Dozgulbas/aps_robot_programs/Data_Analysis/figures/Last10_glass_avg.png

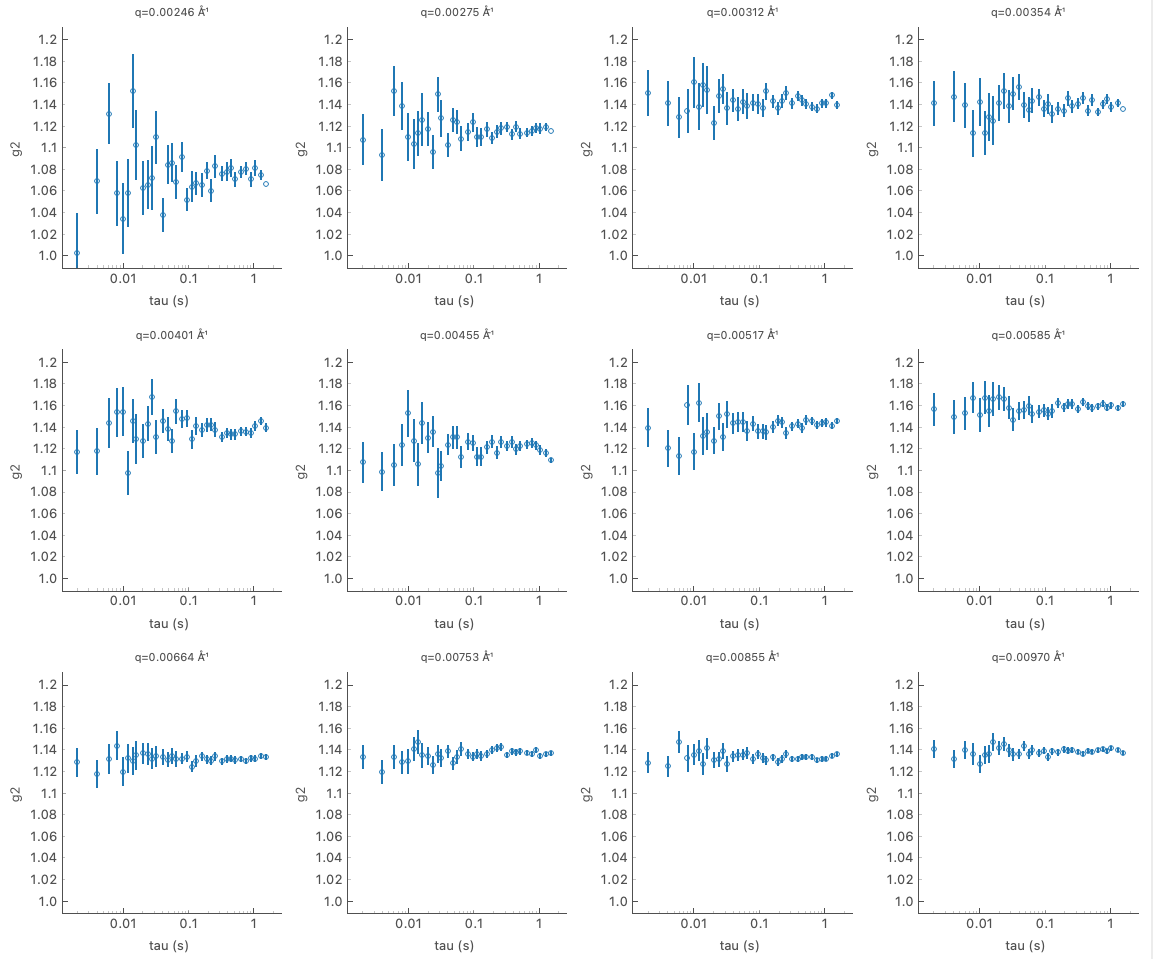
Data_Analysis/figures/Last10_glass_avg.png
