Dozgulbas/aps_robot_programs/droplet_description/meshes/pipette_assembly.stl

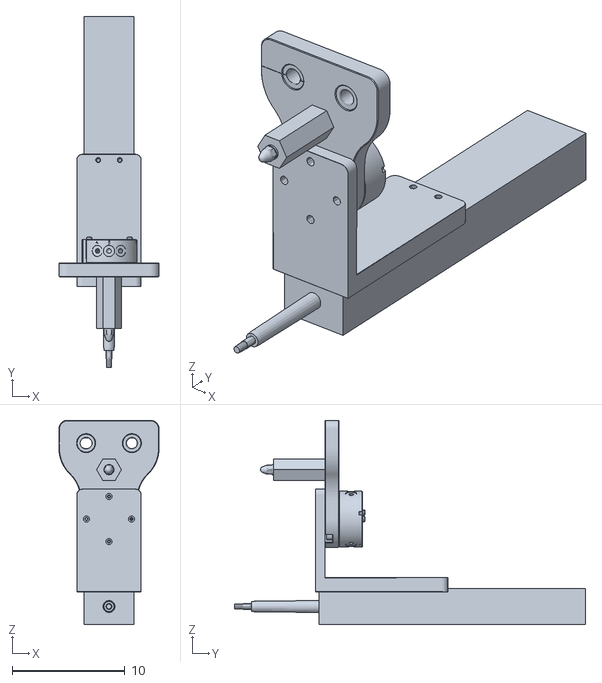
[picture p2: CAD file, 2023-04-10]
droplet_description/meshes/pipette_assembly.stl
8.89 x 31.2 x 18.1
