Dozgulbas/aps_robot_programs/droplet_description/meshes/tool_changer_tool_side.stl

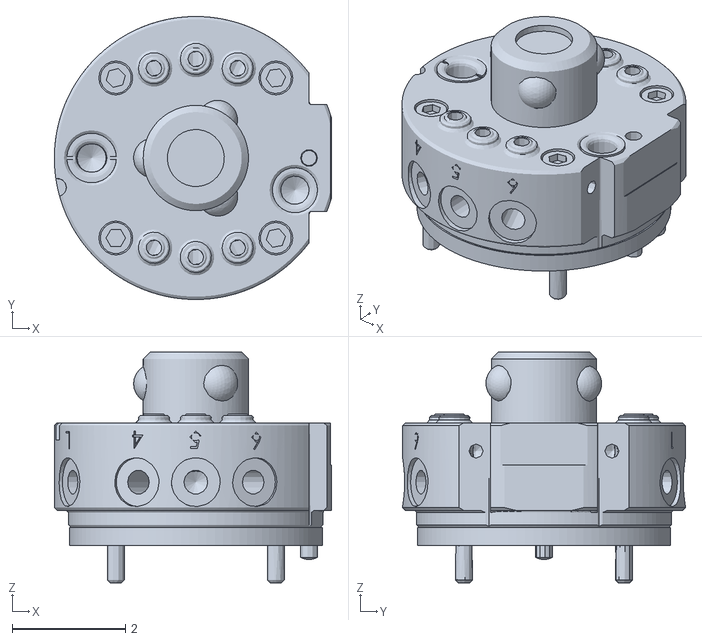
[picture p4: CAD file, 2023-04-10]
droplet_description/meshes/tool_changer_tool_side.stl
4.90 x 5.00 x 4.08
