Dozgulbas/aps_robot_programs/RoboDK_Programs/CAD_drawings/ATI-9120-011M-000-000.STEP

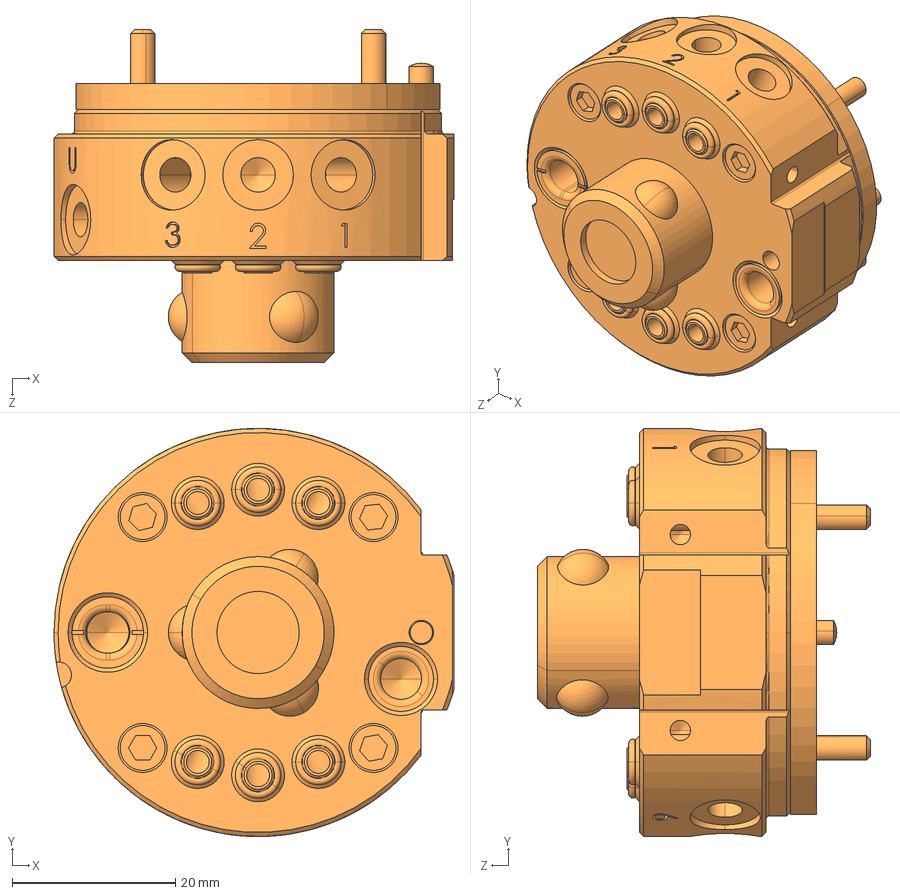
[picture p5: CAD file, 2022-11-21]
RoboDK_Programs/CAD_drawings/ATI-9120-011M-000-000.STEP
49.0 x 50.0 x 40.8 mm
