Dozgulbas/aps_robot_programs/droplet_description/meshes/300ul_tip_1.stl

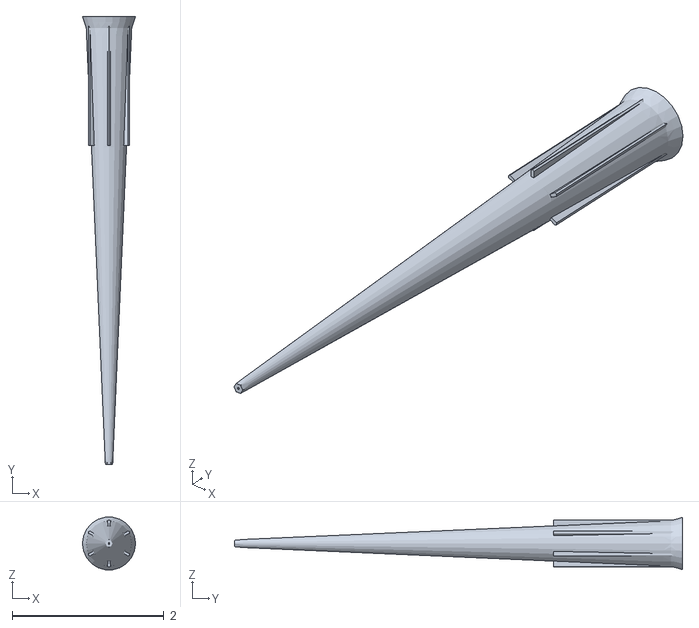
[picture p6: CAD file, 2023-04-10]
droplet_description/meshes/300ul_tip_1.stl
0.7 x 5.90 x 0.693
