Dozgulbas/aps_robot_programs/RoboDK_Programs/CAD_drawings/ATI-9120-TSS-MMB-7124.STEP

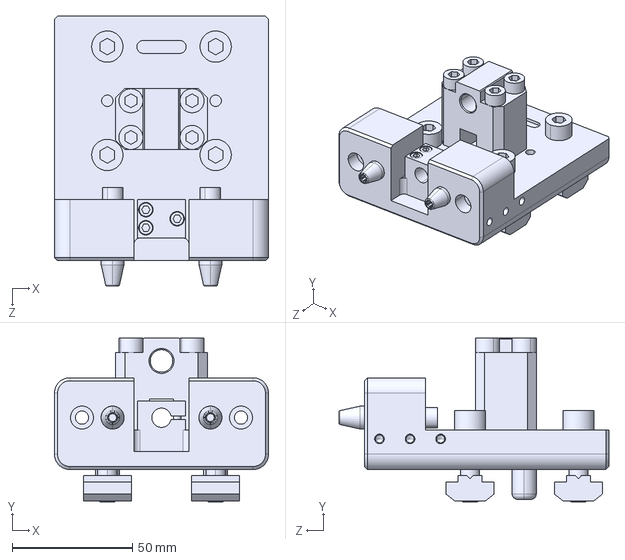
[picture p7: CAD file, 2022-11-21]
RoboDK_Programs/CAD_drawings/ATI-9120-TSS-MMB-7124.STEP
88.9 x 68.1 x 112.1 mm
