Dozgulbas/aps_robot_programs/RoboDK_Programs/CAD_drawings/ATI-9120-TSS-HBQ-7123.STEP

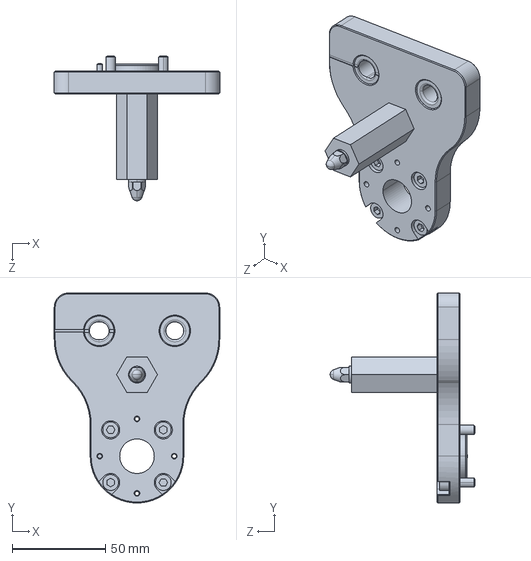
[picture p8: CAD file, 2022-11-21]
RoboDK_Programs/CAD_drawings/ATI-9120-TSS-HBQ-7123.STEP
88.9 x 112.8 x 77.8 mm
