Dozgulbas/aps_robot_programs/RoboDK_Programs/CAD_drawings/5103_a20-40--42707_68308.stp

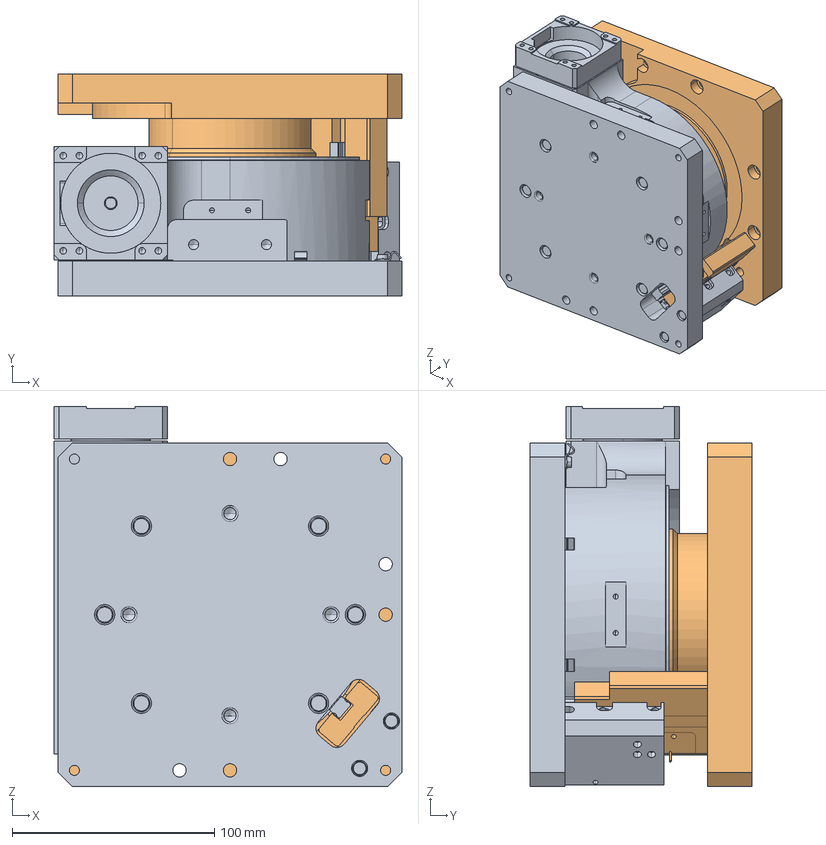
[picture p9: CAD file, 2022-11-21]
RoboDK_Programs/CAD_drawings/5103_a20-40--42707_68308.stp
172.0 x 110.0 x 188.0 mm
5103_A20_BASIS
5103_A20-SUPPORT
