Dozgulbas/aps_robot_programs/RoboDK_Programs/CAD_drawings/L-Bracket.STEP

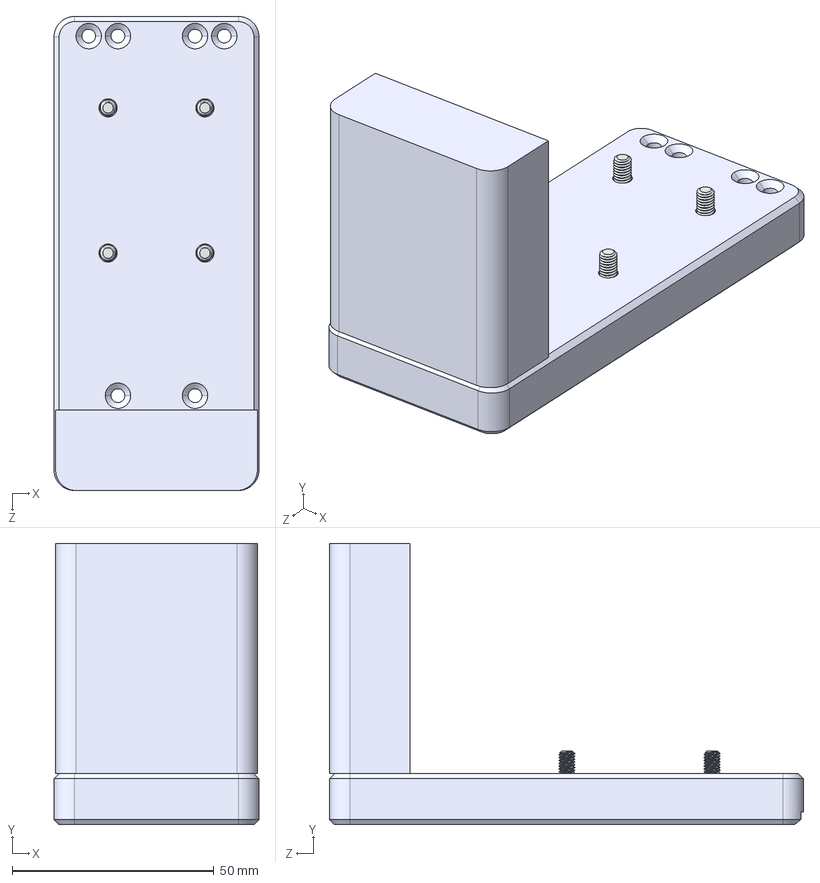
[picture p10: CAD file, 2022-11-21]
RoboDK_Programs/CAD_drawings/L-Bracket.STEP
50.8 x 69.8 x 117.5 mm
P1000 GEN2 Adapter Plate
SHC-M4X10-91292A116_91292A116 x 4
Tool Plate Adapter
