Dozgulbas/aps_robot_programs/RoboDK_Programs/CAD_drawings/5102_20-30--39103.stp

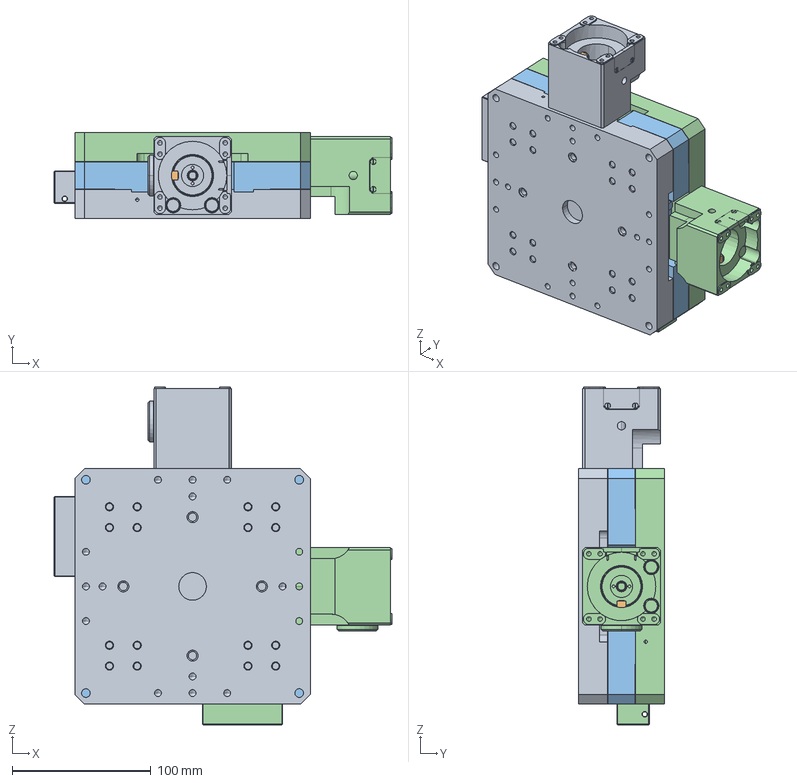
[picture p11: CAD file, 2022-11-21]
RoboDK_Programs/CAD_drawings/5102_20-30--39103.stp
244.1 x 62.0 x 244.1 mm
5102_20-30--39103_BASE
5102_20-30--39103_CROSS_SLIDE
5102_20-30--39103_TOP_SLIDE
