Dozgulbas/aps_robot_programs/RoboDK_Programs/CAD_drawings/ATI-9120-011T-000-000.STEP

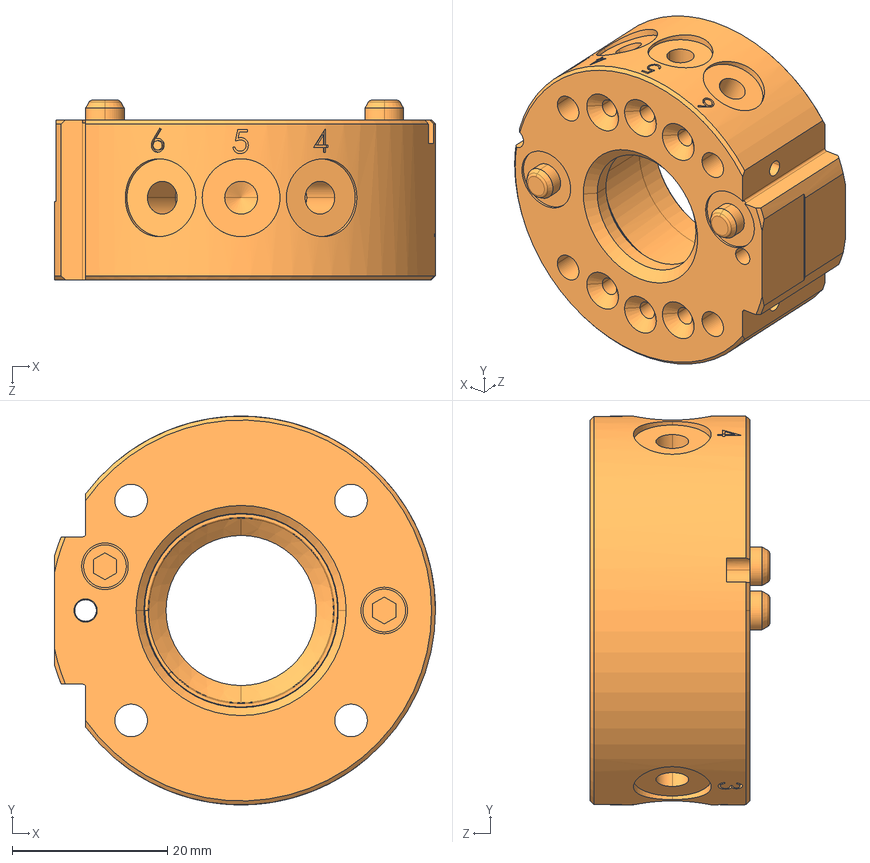
[picture p12: CAD file, 2022-11-21]
RoboDK_Programs/CAD_drawings/ATI-9120-011T-000-000.STEP
49.0 x 50.0 x 23.1 mm
