Dozgulbas/aps_robot_programs/RoboDK_Programs/CAD_drawings/300ul_tip_1.stp

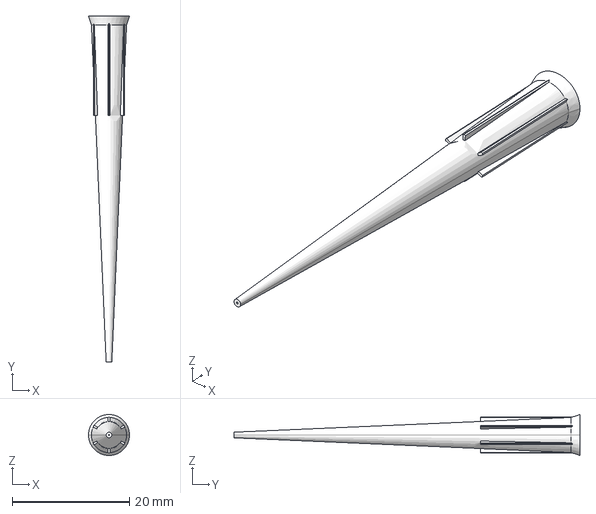
[picture p13: CAD file, 2022-11-21]
RoboDK_Programs/CAD_drawings/300ul_tip_1.stp
7.00 x 59.0 x 7.00 mm
