Dozgulbas/aps_robot_programs/RoboDK_Programs/CAD_drawings/5203_20--53713_1002853.stp

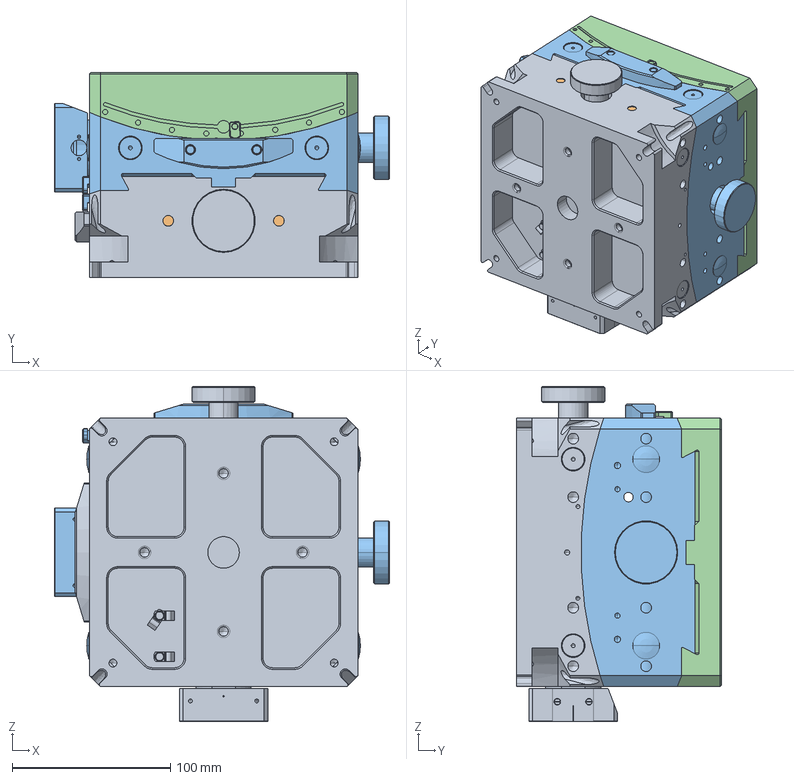
[picture p14: CAD file, 2022-11-21]
RoboDK_Programs/CAD_drawings/5203_20--53713_1002853.stp
212.0 x 130.0 x 212.0 mm
5203_20_BASE--53713_102853
5203_20_CS--53713_102853
5203_20_SLIDE--53713_1028532
