Dozgulbas/aps_robot_programs/RoboDK_Programs/CAD_drawings/91045A-rotary  table-LTB400M.STEP

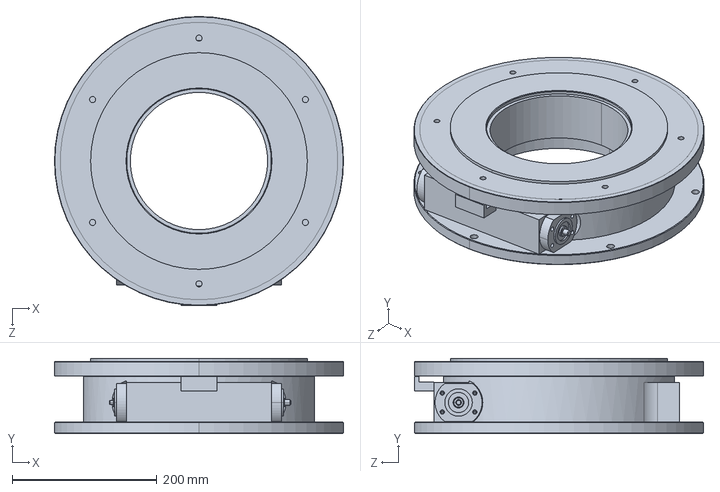
[picture p15: CAD file, 2022-11-21]
RoboDK_Programs/CAD_drawings/91045A-rotary table-LTB400M.STEP
400.0 x 104.0 x 400.0 mm
