Dozgulbas/aps_robot_programs/Data_Analysis/figures/Saxs1D_paper.pdf

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

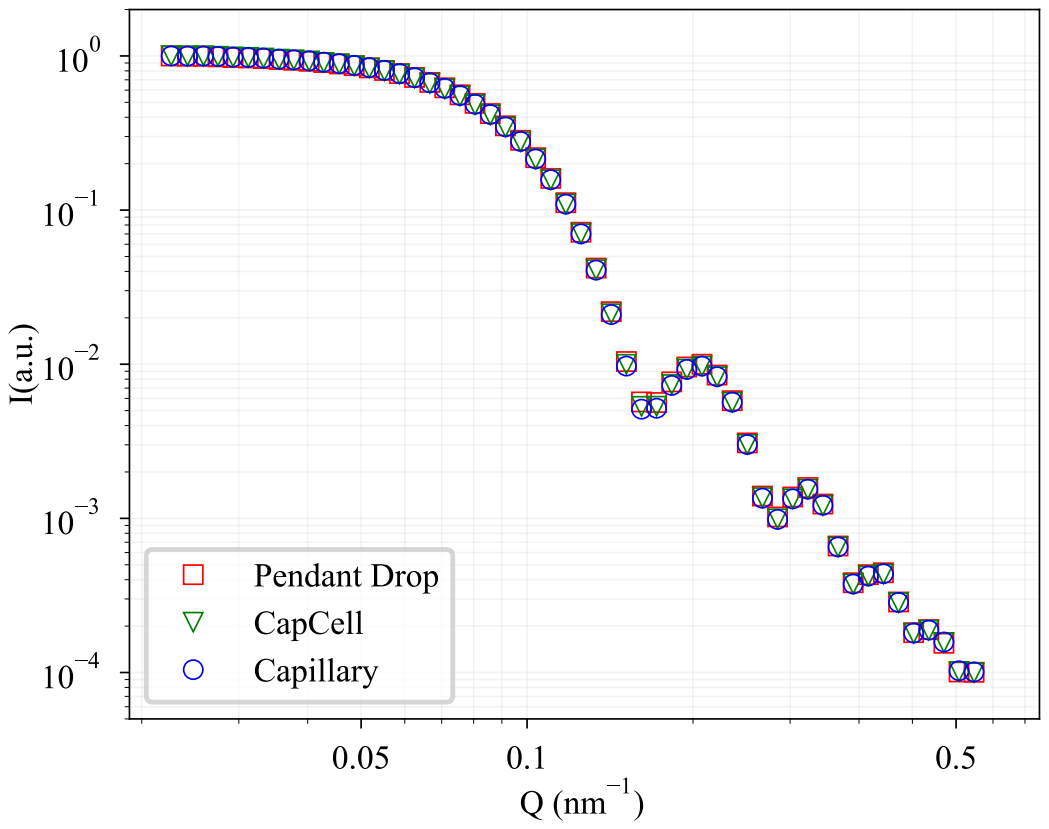
[picture p16: page 1]
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
