Dozgulbas/aps_robot_programs/Data_Analysis/figures/delta_g2_airflow_comparison.pdf

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

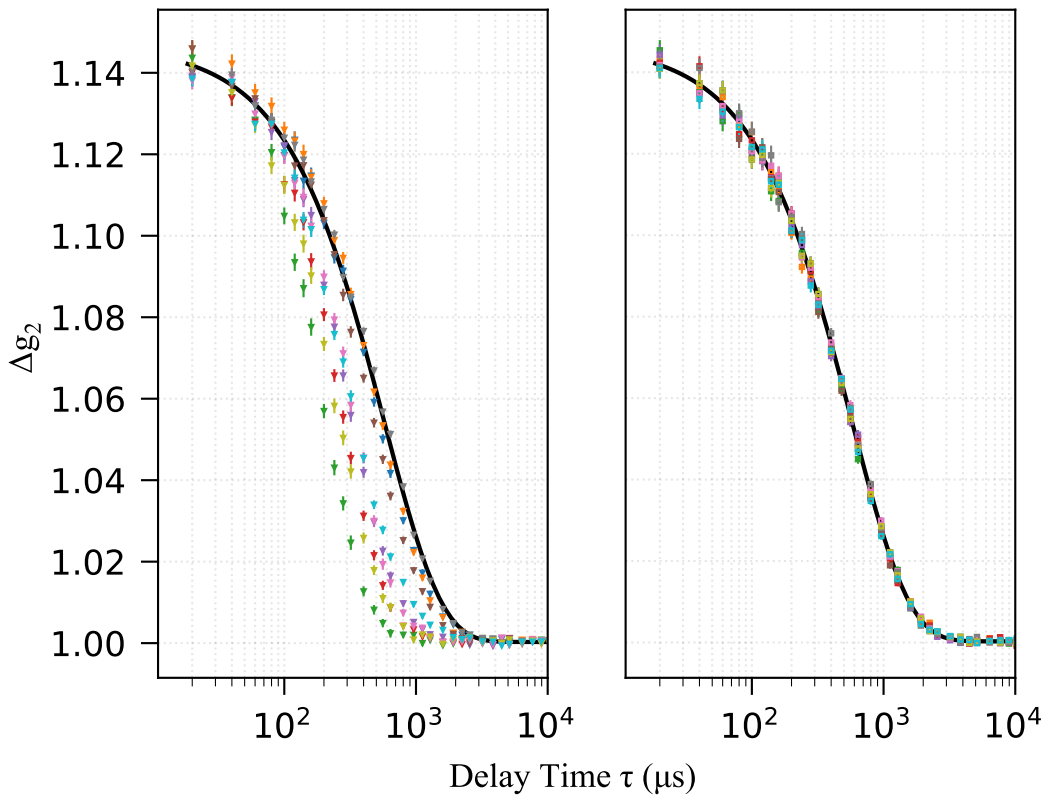
[picture p17: page 1]
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
