Dozgulbas/aps_robot_programs/Data_Analysis/figures/delta_g2_comparison_up_to_ROI10.pdf

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

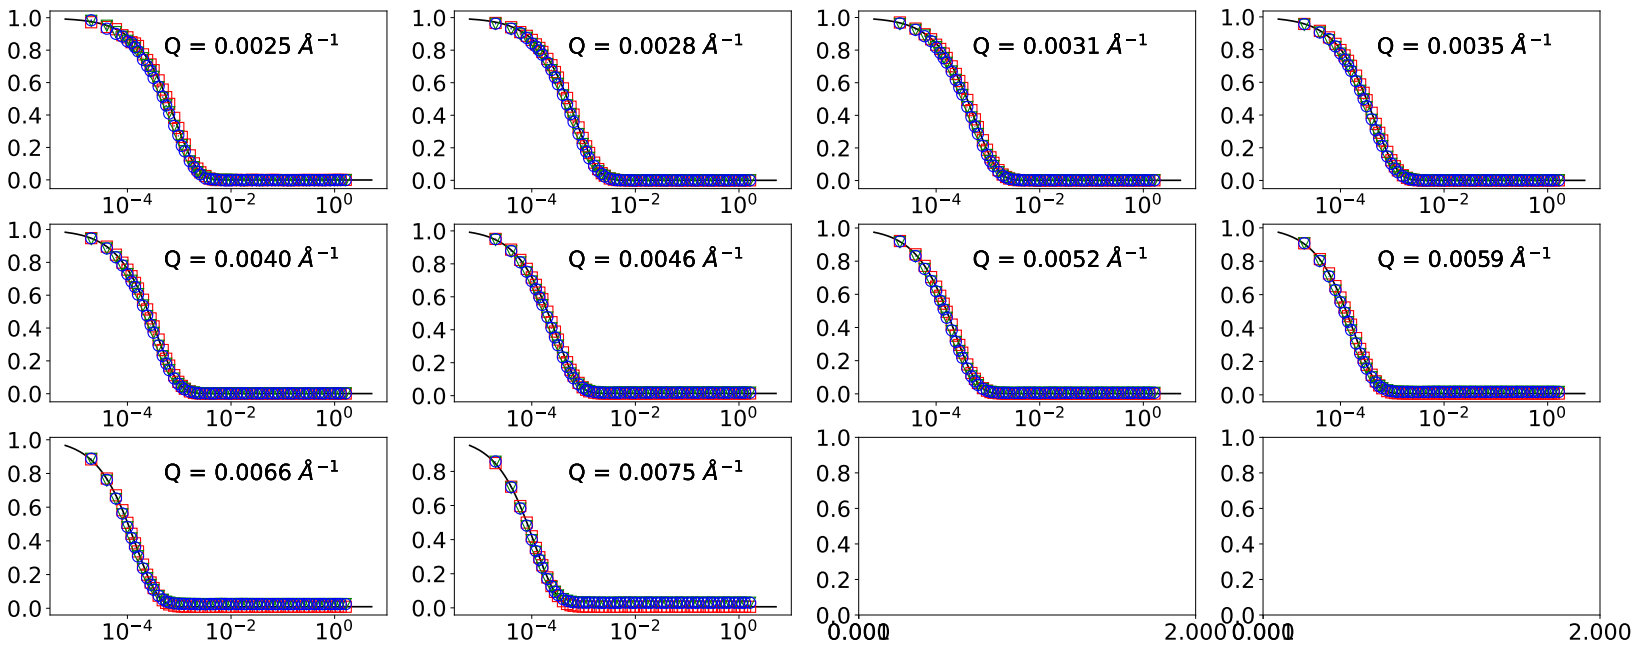
[picture p18: page 1]
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
