Dozgulbas/aps_robot_programs/Data_Analysis/figures/exp_setup.pdf

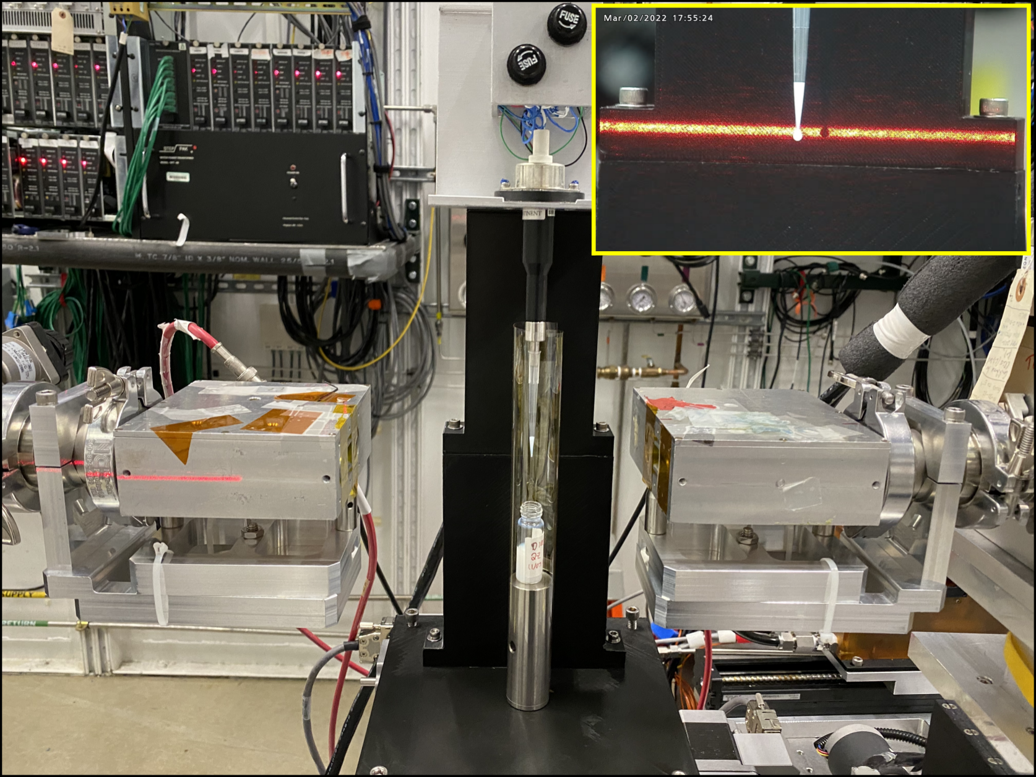
[picture p22: page 1]
