Dozgulbas/aps_robot_programs/(commit log)

2022-11-21 Adding python robot programs
    [300ul_tip_1.stp, 5102_20-30--39103.stp, 5103_a20-40--42707_68308.stp, 5203_20--53713_1002853.stp, 91045A-rotary table-LTB400M.STEP, ATI-9120-011M-000-000.STEP, ATI-9120-011T-000-000.STEP, ATI-9120-TSS-HBQ-7123.STEP]
2022-12-03 Clean up
    [burst_plot.csv, burst_plot_1.csv, burst_plot_2.csv, burst_plot_3.csv, burst_plot_4.csv, burst_plot_5.csv, burst_plot_6.csv, burst_plot_7.csv]
2023-04-07 Creating a description package
    [PF400.urdf, PF400.urdf.xacro, PF400_Hand.STL, PF400_Inner_Link.STL, PF400_Outer_Link.STL, PF400_Z_Carriage.STL, end_effector.STL, gripper_finger_left.STL]
2023-04-10 Adding droplet meshes
    [300ul_tip_1.stl, ATI-9120-011M-000-000.stl, PF400_Hand.STL, PF400_Inner_Link.STL, PF400_Outer_Link.STL, PF400_Z_Carriage.STL, PIPET_ASSEMBLY.stl, end_effector.STL]
2023-04-10 Renaming the meshes
    [A558-000250_FOR_DOGO_26-MAY-2022.stl, ATI-9120-011M-000-000.stl, PF400.urdf, PIPET_ASSEMBLY.stl, droplet.urdf, pipette_assembly.stl, tool_changer_tool_side.stl]
2023-04-10 Working on the droplet urdf
    [droplet.urdf]
2023-04-10 Working on fixing urdf errors
    [droplet.urdf]
2023-04-10 Orginizing the repo
    [300ul_tip_1.stl, PF400.urdf.xacro, droplet.urdf, droplet_base.stl, materials.xacro, module_carts.urdf.xacro, pcr_workcell.urdf.xacro, pf400_module.xacro]
